rvkshn-10/Triple-Drift-Synth/BOM.csv

Item | Qty | Supplier | Cost/item | Total Cost | link
NE555P DIP-8 timer | 3 | Tayda | $0.25 | $0.75 | https://www.taydaelectronics.com/ne555-ic-555-timer-dip-8.html
LM386N-1 DIP-8 amplifier | 1 | Tayda | $0.85 | $0.85 | https://www.taydaelectronics.com/lm386-audio-amplifier-1-channel-mono-class-ab-325mwx1at8-ohm-4v-12v-pdip-8.html
1N5817 Schottky diode | 1 | Tayda | $0.06 | $0.06 | https://www.taydaelectronics.com/1n5817-diode-schottky-1a-20v.html
22 ohm 1/4W resistor | 10 | Tayda | $0.12 | $1.20 | https://www.taydaelectronics.com/save-time-easy-group-3.html
10 ohm 1/4W resistor | 1 | Tayda | $0.12 | $0.12 | https://www.taydaelectronics.com/save-time-easy-group-3.html
1k ohm 1/4W resistor | 1 | Tayda | $0.12 | $0.12 | https://www.taydaelectronics.com/save-time-easy-group-3.html
4.7k ohm 1/4W resistor | 10 | Tayda | $0.12 | $1.20 | https://www.taydaelectronics.com/save-time-easy-group-3.html
10k ohm 1/4W resistor | 1 | Tayda | $0.12 | $0.12 | https://www.taydaelectronics.com/save-time-easy-group-3.html
100k ohm 1/4W resistor | 1 | Tayda | $0.12 | $0.12 | https://www.taydaelectronics.com/save-time-easy-group-3.html
470uF 16V radial capacitor | 2 | Tayda | $0.06 | $0.12 | https://www.taydaelectronics.com/capacitors/electrolytic-capacitors/470uf-16v-105c-radial-electrolytic-capacitor-8x12mm.html
100nF 50V ceramic bypass capacitor (buy 10; use 5) | 10 | Tayda | $0.01 | $0.10 | https://www.taydaelectronics.com/capacitors/ceramic-disc-capacitors/test-group-2-caps.html
100nF 100V 5% film capacitor | 6 | Tayda | $0.10 | $0.60 | https://www.taydaelectronics.com/0-1uf-100v-5-kemet-polyester-film-box-type-capacitor.html
10nF 50V ceramic bypass capacitor (buy 10; use 3) | 10 | Tayda | $0.01 | $0.10 | https://www.taydaelectronics.com/capacitors/ceramic-disc-capacitors/test-group-2-caps.html
1uF 100V film capacitor | 1 | Tayda | $0.21 | $0.21 | https://www.taydaelectronics.com/1uf-100v-5-polyester-film-box-type-capacitor-jfj.html
10uF 50V radial capacitor | 1 | Tayda | $0.04 | $0.04 | https://www.taydaelectronics.com/capacitors/electrolytic-capacitors/10-uf-50v-85c-electrolytic-capacitor-aishi-6985.html
220uF 25V radial capacitor | 1 | Tayda | $0.25 | $0.25 | https://www.taydaelectronics.com/capacitors/electrolytic-capacitors/220uf-25v-105c-radial-electrolytic-capacitor-8x11.html
47nF 100V film capacitor | 1 | Tayda | $0.07 | $0.07 | https://www.taydaelectronics.com/47nf-0-047uf-100v-5-polyester-film-box-type-capacitor.html
B100k linear 6mm round shaft pot | 3 | Tayda | $0.39 | $1.17 | https://www.taydaelectronics.com/100k-ohm-linear-taper-potentiometer-with-solder-lug-shaft-dia-6mm.html
A100k log 6mm round shaft pot | 3 | Tayda | $0.50 | $1.50 | https://www.taydaelectronics.com/potentiometer-variable-resistors/rotary-potentiometer/logarithmic/100k-ohm-logarithmic-taper-potentiometer-round-shaft-solder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
A10k log 6mm round shaft pot | 1 | Tayda | $0.50 | $0.50 | https://www.taydaelectronics.com/10k-ohm-logarithmic-taper-potentiometer-round-shaft-solder-lugs-13579.html
Mini SPDT ON-ON toggle | 5 | Tayda | $0.47 | $2.35 | https://www.taydaelectronics.com/electromechanical/switches-key-pad/toggle-switch/mini-toggle-switch-spdt-on-on.html
12mm normally-open PLAY button | 1 | Tayda | $0.22 | $0.22 | https://www.taydaelectronics.com/electromechanical/switches-key-pad/push-button/push-button-switch-momentary-spst-3a-125vac-12mm-red.html
9V battery snap | 1 | Tayda | $0.20 | $0.20 | https://www.taydaelectronics.com/9v-9-volt-battery-clip-connector-snap-t-type.html
57mm 8 ohm 1W speaker HY57MS0810-H8.4 | 1 | Tayda | $0.95 | $0.95 | https://www.taydaelectronics.com/hardware-tools/speakers/mylar-speaker-8-ohm-1w.html
22 AWG stranded hookup wire, brown | 10 | Tayda | $0.10 | $1.00 | https://www.taydaelectronics.com/awg-22-brown-hook-up-wire-1ft-30cm-stranded-600v.html
PCB fabrication batch of 5 | 1 | JLCPCB | $2.00 | $2.00 | https://jlcpcb.com/
3D print base | 1 | JLC3DP | $10.85 | $10.85 | https://jlc3dp.com/
3D print lid | 1 | JLC3DP | $4.43 | $4.43 | https://jlc3dp.com/
3D print grip-knob | 7 | JLC3DP | $0.32 | $2.24 | https://jlc3dp.com/
3D print speaker-bridge | 1 | JLC3DP | $0.32 | $0.32 | https://jlc3dp.com/
3D print battery-pull-grip | 1 | JLC3DP | $0.32 | $0.32 | https://jlc3dp.com/
1.5mm heat-shrink tubing, red, 20cm | 5 | Tayda | $0.50 | $2.50 | https://www.taydaelectronics.com/heat-shrink-tubing-20cm-1-5mm-red.html
Estimated total shipping | 1 |  |  | $45.49
