rvkshn-10/Triple-Drift-Synth/cad/cost-revision/reused-M3-knob-detail.png

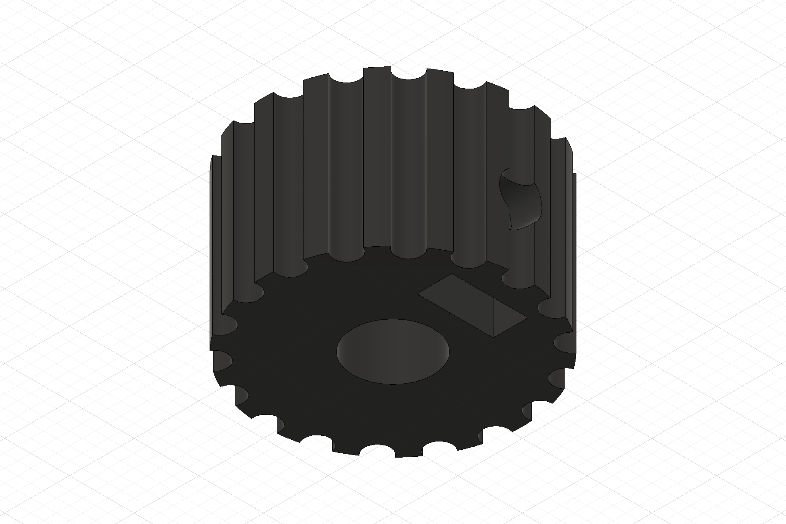
cad/cost-revision/reused-M3-knob-detail.png
