rvkshn-10/Triple-Drift-Synth/cad/cost-revision/speaker-mount.png

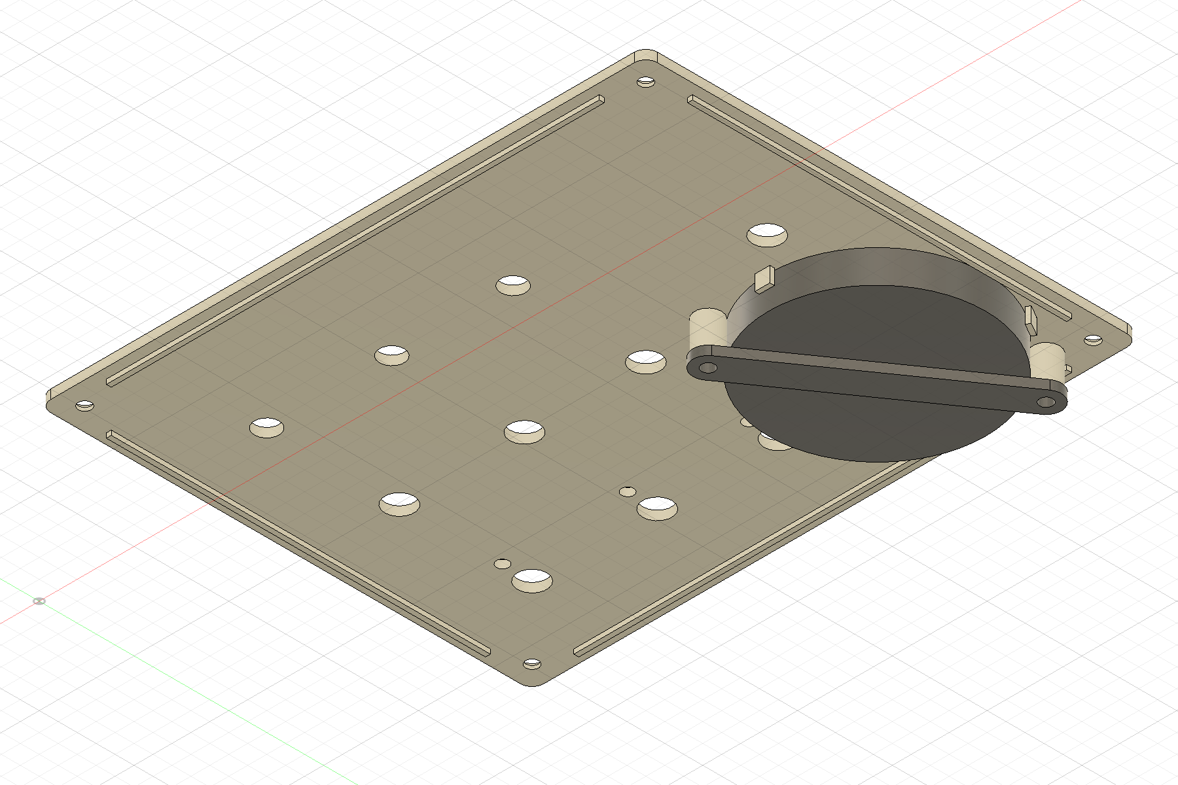
cad/cost-revision/speaker-mount.png
