rvkshn-10/Triple-Drift-Synth/cad/cost-revision/top.png

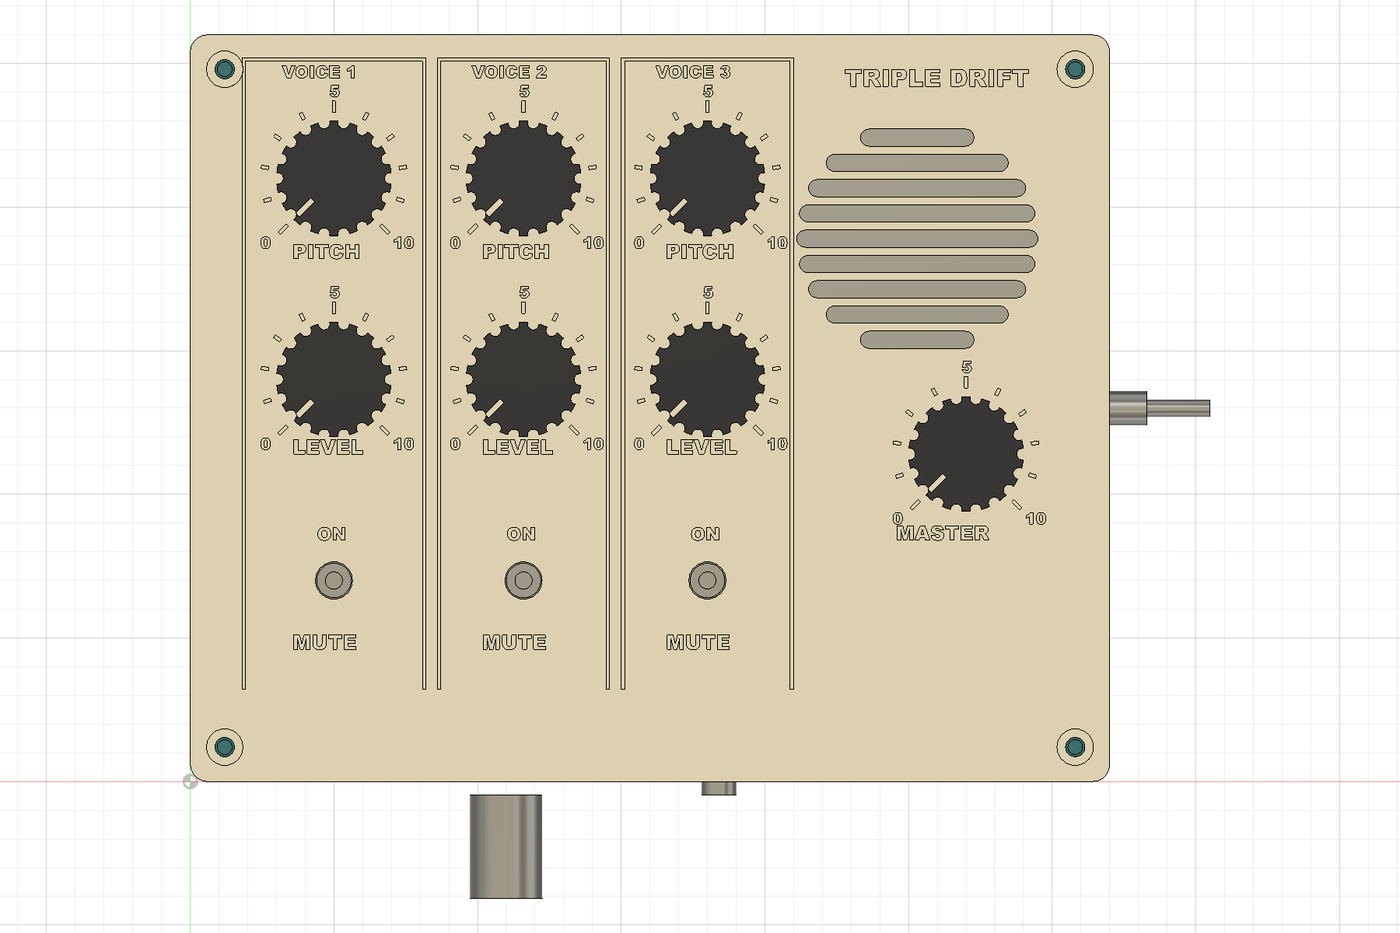
cad/cost-revision/top.png
