rvkshn-10/Triple-Drift-Synth/cad/cost-revision/print-files/TripleDrift-base.stl

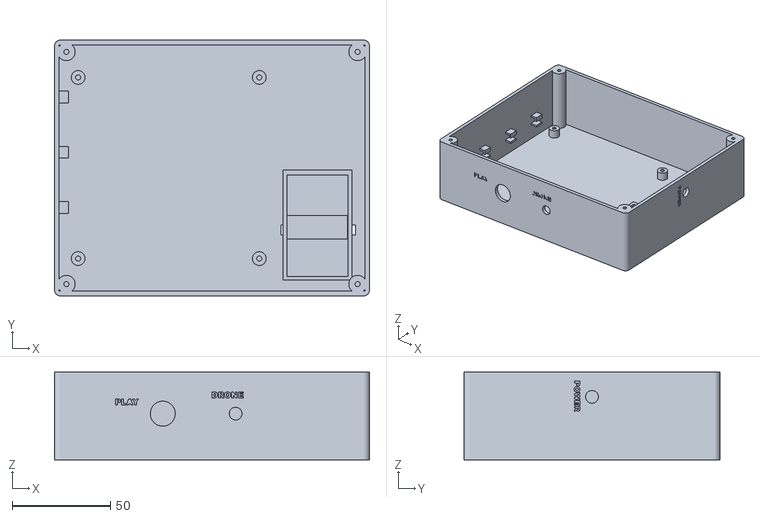
[picture p6: CAD file, 2026-10-25]
cad/cost-revision/print-files/TripleDrift-base.stl
160.0 x 130.0 x 44.6
