rvkshn-10/Triple-Drift-Synth/cad/cost-revision/TripleDrift-CostRevision.step

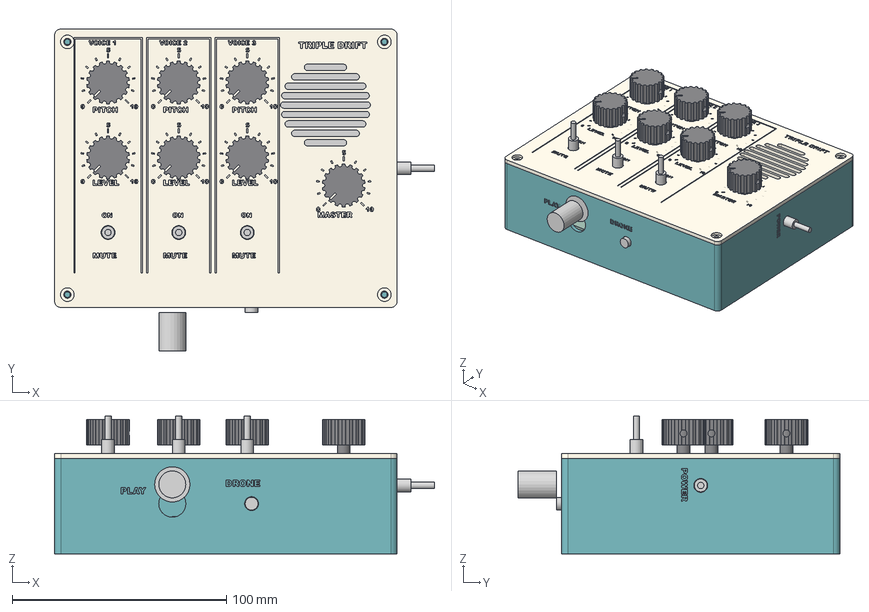
[picture p7: CAD file, 2026-10-25]
cad/cost-revision/TripleDrift-CostRevision.step
177.4 x 150.3 x 64.4 mm
DIP-8_W7.62mm_1 x 4
C_Disc_D50mm_W25mm_P500mm x 15
R_Axial_DIN0207_L63mm_D25mm_P1016mm_Horizontal x 16
PinHeader_1x02_P254mm_Vertical x 8
PinHeader_1x03_P254mm_Vertical x 7
C_Rect_L7.2mm_W2.5mm_P5.00mm_1
CP_Radial_D80mm_P350mm x 3
CP_Radial_D50mm_P200mm
D_DO-41_SOD81_P10.16mm_Horizontal_1
TripleDrift_PCB
