rvkshn-10/Triple-Drift-Synth/cad/cost-revision/print-files/TripleDrift-lid.stl

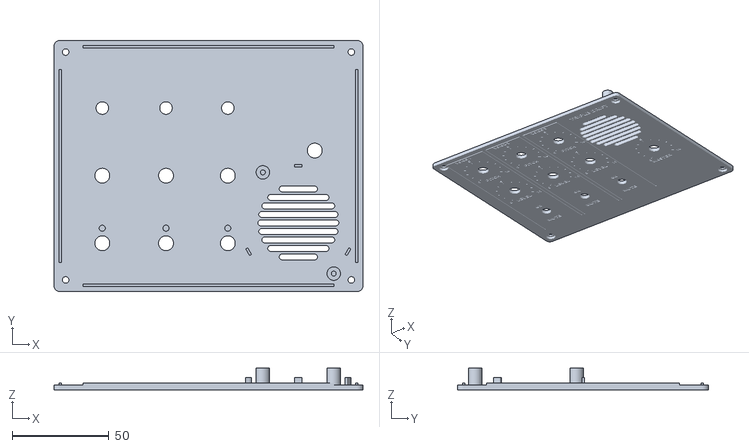
[picture p8: CAD file, 2026-10-25]
cad/cost-revision/print-files/TripleDrift-lid.stl
160.0 x 130.0 x 11.2
