rvkshn-10/Triple-Drift-Synth/cad/cost-revision/print-files/TripleDrift-battery-pull-grip.stl

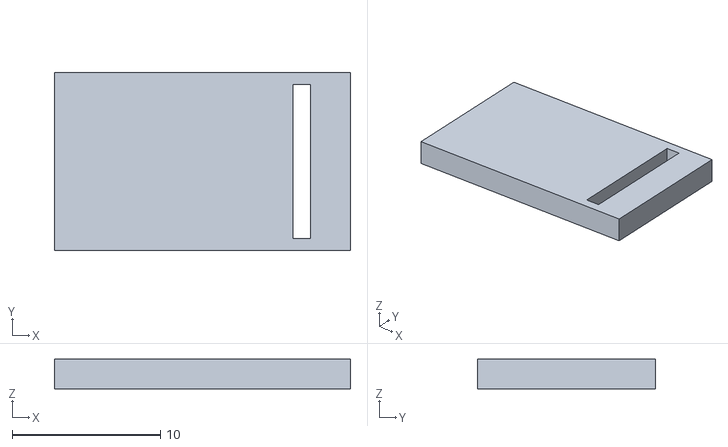
[picture p9: CAD file, 2026-10-25]
cad/cost-revision/print-files/TripleDrift-battery-pull-grip.stl
20.0 x 12.0 x 2.00
