rvkshn-10/Triple-Drift-Synth/cad/cost-revision/print-files/TripleDrift-grip-knob.stl

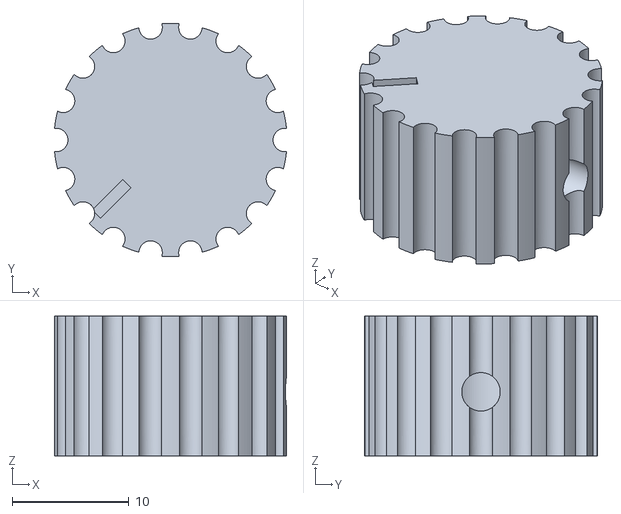
[picture p10: CAD file, 2026-10-25]
cad/cost-revision/print-files/TripleDrift-grip-knob.stl
19.9 x 20.0 x 12.0
