rvkshn-10/Triple-Drift-Synth/cad/cost-revision/print-files/TripleDrift-speaker-bridge.stl

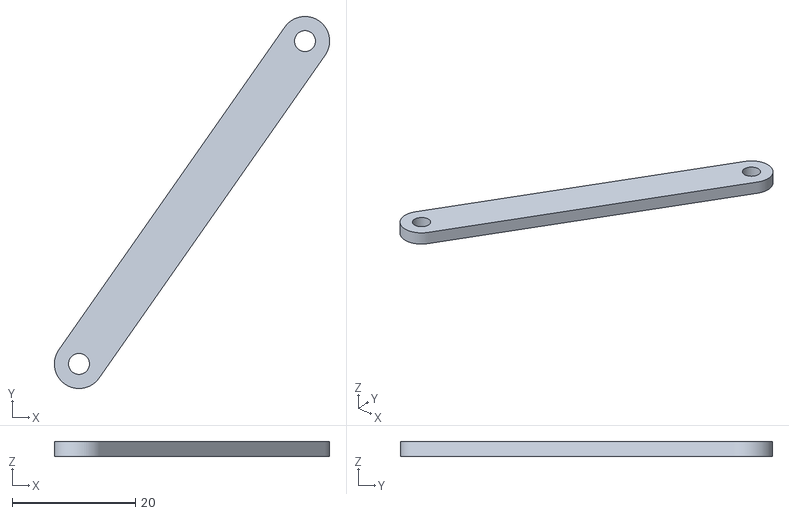
[picture p11: CAD file, 2026-10-25]
cad/cost-revision/print-files/TripleDrift-speaker-bridge.stl
44.7 x 60.4 x 2.40
