rvkshn-10/Triple-Drift-Synth/(list of files, cad)

Other CAD files:
cad/cost-revision/TripleDrift-CostRevision.f3d
