rvkshn-10/Triple-Drift-Synth/cad/cost-revision/assembled.png

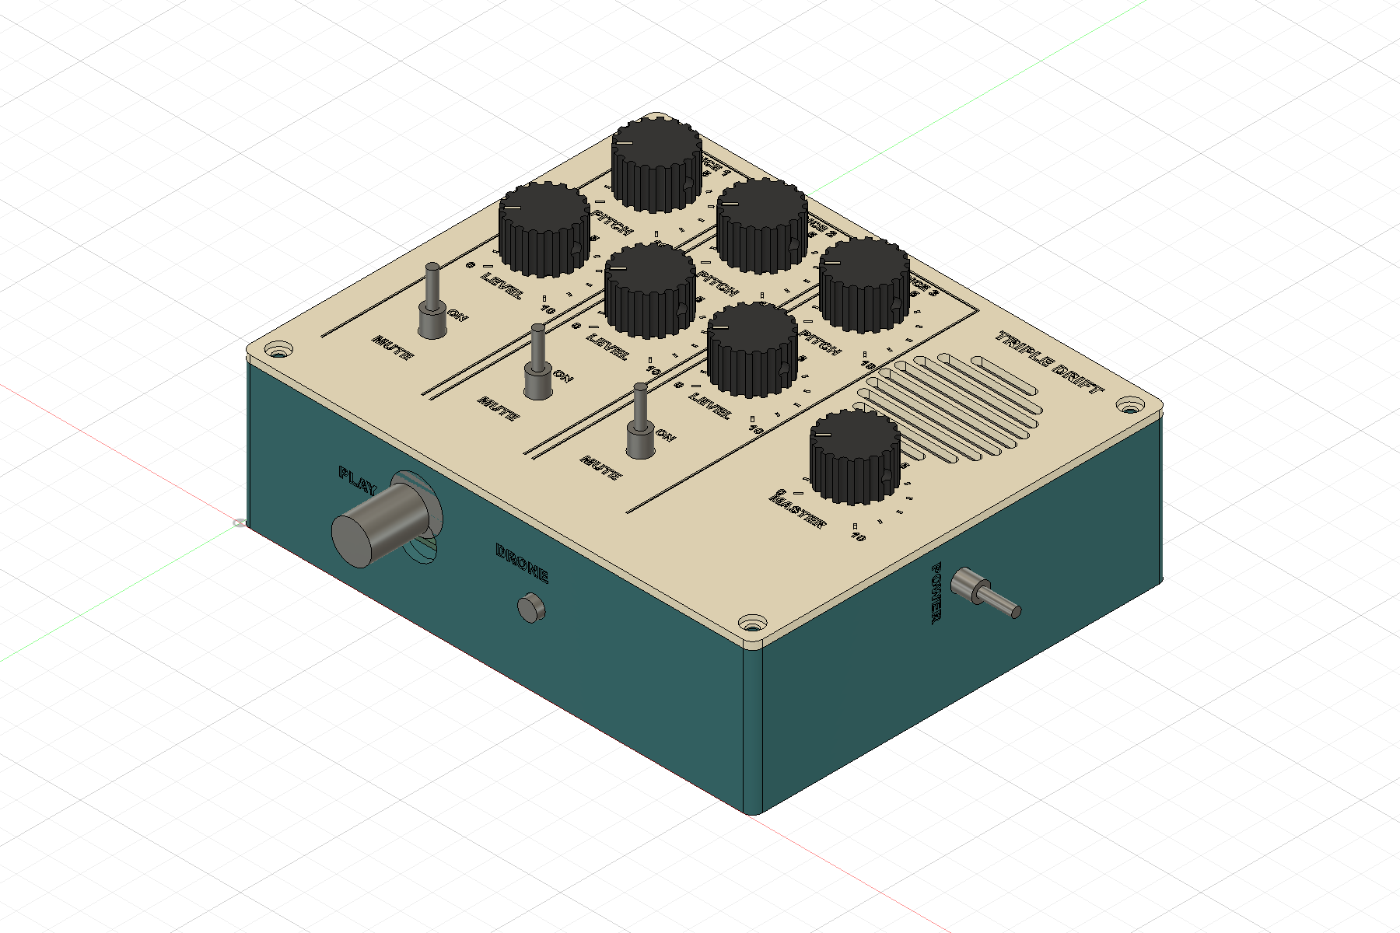
cad/cost-revision/assembled.png
