rvkshn-10/Triple-Drift-Synth/JOURNAL.md

# Triple Drift Desktop Synth – devlog

<!-- Generated by Half Life from project cmvfd73yg000001q7hnh0gmxl. Edits here are overwritten on the next sync. -->
<!-- Generated: 2026-10-24T23:02:02.855Z -->

> [!NOTE]
> This devlog is mirrored from [Half Life](https://halflife.hackclub.com) – [open the project](https://halflife.hackclub.com/projects/cmvfd73yg000001q7hnh0gmxl). Editing it here will not change the platform's copy, and the next sync overwrites this file.

> Desktop synth with three 555 oscillators, each with a pitch knob and mute switch and a mixer so we can blend the voices, a Master volume, a small amplifier and a built in speaker. A Play button along with a continuous drone mode along with a printed enclosure.  (Cover image is AI btw)

| Week | Tier | Hours logged | Entries |
| --- | --- | --- | --- |
| Week 3 | Tier 2 | 33h | 3 |

## Contents

1. [2026-10-20 – October 20th](#2026-10-20-october-20th)
2. [2026-10-21 – October 21st](#2026-10-21-october-21st)
3. [2026-10-24 – October 24th](#2026-10-24-october-24th)

## Design

### 2026-10-20 – October 20th

**11h**

October 20th

To build a desktop synth, I divided my work into 3 different phases, the first phase is the PCB phase, then it's CAD phase, and finally the Refinement phase.

First I began with planning the circuit, I established the signal flow of three 555 oscillators feed individual level controls, a mixer, and a speaker amplifier. Also planned the battery power and play/drone controls.
01-architecture

I then started designing the first voice, I created one complete 55 oscillator circuit with adjustable pitch, a mute switch, and an output-level control
02-single-voice

I later added all three voices, by repeating the oscillator circuit to create three independently adjustable voices that can be mixed together.
03-three-voice-schematic

Next I added the power and playback controls, apparently for this one I needed a battery-polarity protection, supply filtering. But I also had the PLAY and DRONE controls that enabled the oscillators.
04-power-play-drone

I continued by designing the speaker amplifier, I added the master volume control, LM386 amplifier, output capacitor, and supporting components to drive an external speaker.
05-speaker-amplifier

Then I I had to use the KiCad Rules Checker, and the Schematic passed with 0 errors and 0 warnings. At this point I was done with the schematic.
06-erc-zero-violations

I later arranged the through hole components and control headers on a 100x100mm board, with 4 mounting holes for the future enclosure when I complete phase 2.
07-pcb-placement

-Short break-

Next I routed the PCB by connecting the component pads using copper traces on both sides of the board. The completed routing had 0 unconnected pads.
08-complete-routing

Then I inspected the power, mixer, and speaker amplifier area in detail and refined the silkscreen labels to avoid overlaps.
09-amplifier-routing-detail

Then I ran the KiCad Design rules checker to check layout against manufacturing rules. The board passed with 0 errors, 0 warnings, and 0 unconnected pads.
10-drc-zero-violations

Finally I took a look at the board in 3d, to view the finished PCB with component models to review the layout and prepare a reference for Phase 2 enclosure design.
11-pcb-3d-view

P.S. This entry doesn't include information of me researching how to do this project and best things to use because I forgot to take screenshots.

### 2026-10-21 – October 21st

**10h**

October 21st

I started with the enclosure footprint and reserved space for the 100mmx100mm PCB, controls, speaker and battery. This helped me decide a layout before adding the case features.
01-footprint-layout

I next created the base by building the hollow enclosure with 2.4mm walls and floor, then rounded the outside corners. The open top gives access for installing and wiring the electronics
02-hollow-base

I then needed to add supports so I created 4 mounting posts aligned to the board's 92 mm hole spacing. And then blind screw pilot holes keep the screw paths above the bottom surface.
03-pcb-standoffs

I then created internal mounting features. I added the battery rails and stops, cable tie slots, and 4 corner pillars for securing the lid. The top view shows the placement around the PCB space. The rear cradle corners received a small joining repair during final mesh validation.
04-battery-cradle-lid-pillars

I next had to open the case for controls, so I cut the front Play Button and Drone switch holes, and the right side power switch hole. The sizes are provisional until the exact controls were selected.
05-front-side-control-holes

Then I had to lay out the panel, so I created the lid and placed openings for 3 pitch pots, 3 level pots, and 2 mute switches, master volume, and the 4 lid screws.
06-lid-control-layout

I later got inspirations for this next idea from my PC, where it had speaker grills, and I decided to incorporate that into the lid. I also modeled the underside speaker guides, so measurement was key here, screw bosses, and a separate retaining bridge, those underside features aren't visible, but I will show them in the Reel.
07-speaker-grille

Next I planned to label stuff, so I recessed the project name, and control labels into the lid. During the final refinement I made the lettering bolder to improve its chances of printing clearly.
08-engraved-control-panel

I then checked the internal layout, so I imported the actual Phase 1 PCB STEP model, corrected its position, and checked its placement inside the base. Simplified controls, speaker, and battery show the intended packaging. Those purchased part models still need confirmation against real supplier dimensions.
09-internal-pcb-fit

Finally I assembled the teal base with he cream panel with provisional black controls and an orange PLAY button. I then checked feature health, checked printed part intersections against the available models, and exported the native Fusion design, STEP assembly, and 3 STL parts.
10-complete-enclosure

### 2026-10-24 – October 24th

**12h**

October 24th

This is  now Phase 3, where I add new features and enhance my overall workflow, so my first change was finger grip knobs, so I replaced the 7 smooth placeholder knobs with editable printable knob design having 18 finger scallops, a provisional 6.2mm shaft bore, and a M3 set screw pilot. I had to make sure base geometry was unchanged.
01-finger-grip-knobs

Next plan was to work on Knob Pointers, I id it on one knob which was reused a lot, so it updated all 7 instances together. The point was so that the setting can be read against the panel scales.
02-knob-position-pointers

Next plan was to add Pitch scales, by adding 11 engraved tick marks, 0, 5, 10 labels around each pitch knob. I had to move the title and voices headings to visibly view the scales though.
03-numbered-pitch-scales

Next was to add volume scales, I added matching scales around the 3 voice level knobs and master volume. These are relative settings, not calibrated frequencies or decibels (because it really doesn't matter).
04-volume-scales

Next I added voice groups, so I engraved 3 open bottom borders to group each voice's pitch, level, and mute controls.
05-voice-grouping-borders

I next created mute positions, by adding an ON above each mute toggle, opposite the existing MUTE labels. Final switch orientation and wiring must match the labels during assembly. ( a note to be added to the GitHub)
06-on-and-mute-labels

Next was to create external labels, I engraved the PLAY and DRONE on the front wall, and POWER on the right wall beside their existing mounting holes.
07-play-drone-power-labels

Next I added recessed lid screws, by adding four 6.4mm diameter, and 1.5mm deep screw head pockets. Flush mounting requires suitably low profile screwheads, the ordinary pan heads may protrude.
08-recessed-lid-screw-heads

Next I wanted to work on wiring, so I added wire routing clips, by adding three C-shaped retaining clips along the left interior wall. This view hides the electronics so the clips are visible. They keep the intended wire path beside the PCB.
09-internal-wire-routing-clips

The next step was the Battery pull tab, so I added a shallow ribbon channel beneath the battery and a separate printed grip with a matching ribbon slot, the orange grip and cream ribbon ref are shown about the battery. Ribbon material might have to be bought.
10-battery-pull-tab

Next I made rubber foot pockets, by recessing four 12.4 mm diameter seats into the underside for nominal 12mm adhesive feet. Pocket depth is 0.6mm.
11-rubber-foot-pockets

Next I made a speaker grill, I replaced the circular perforations with 7 rounded slots within the same speaker area. The nominal webs are 1.4mm wide. I did this for a better design
12-improved-speaker-grille
