rvkshn-10/Triple-Drift-Synth/TripleDrift.kicad_pcb

## KiCad design TripleDrift.kicad_pcb (2026-10-25)

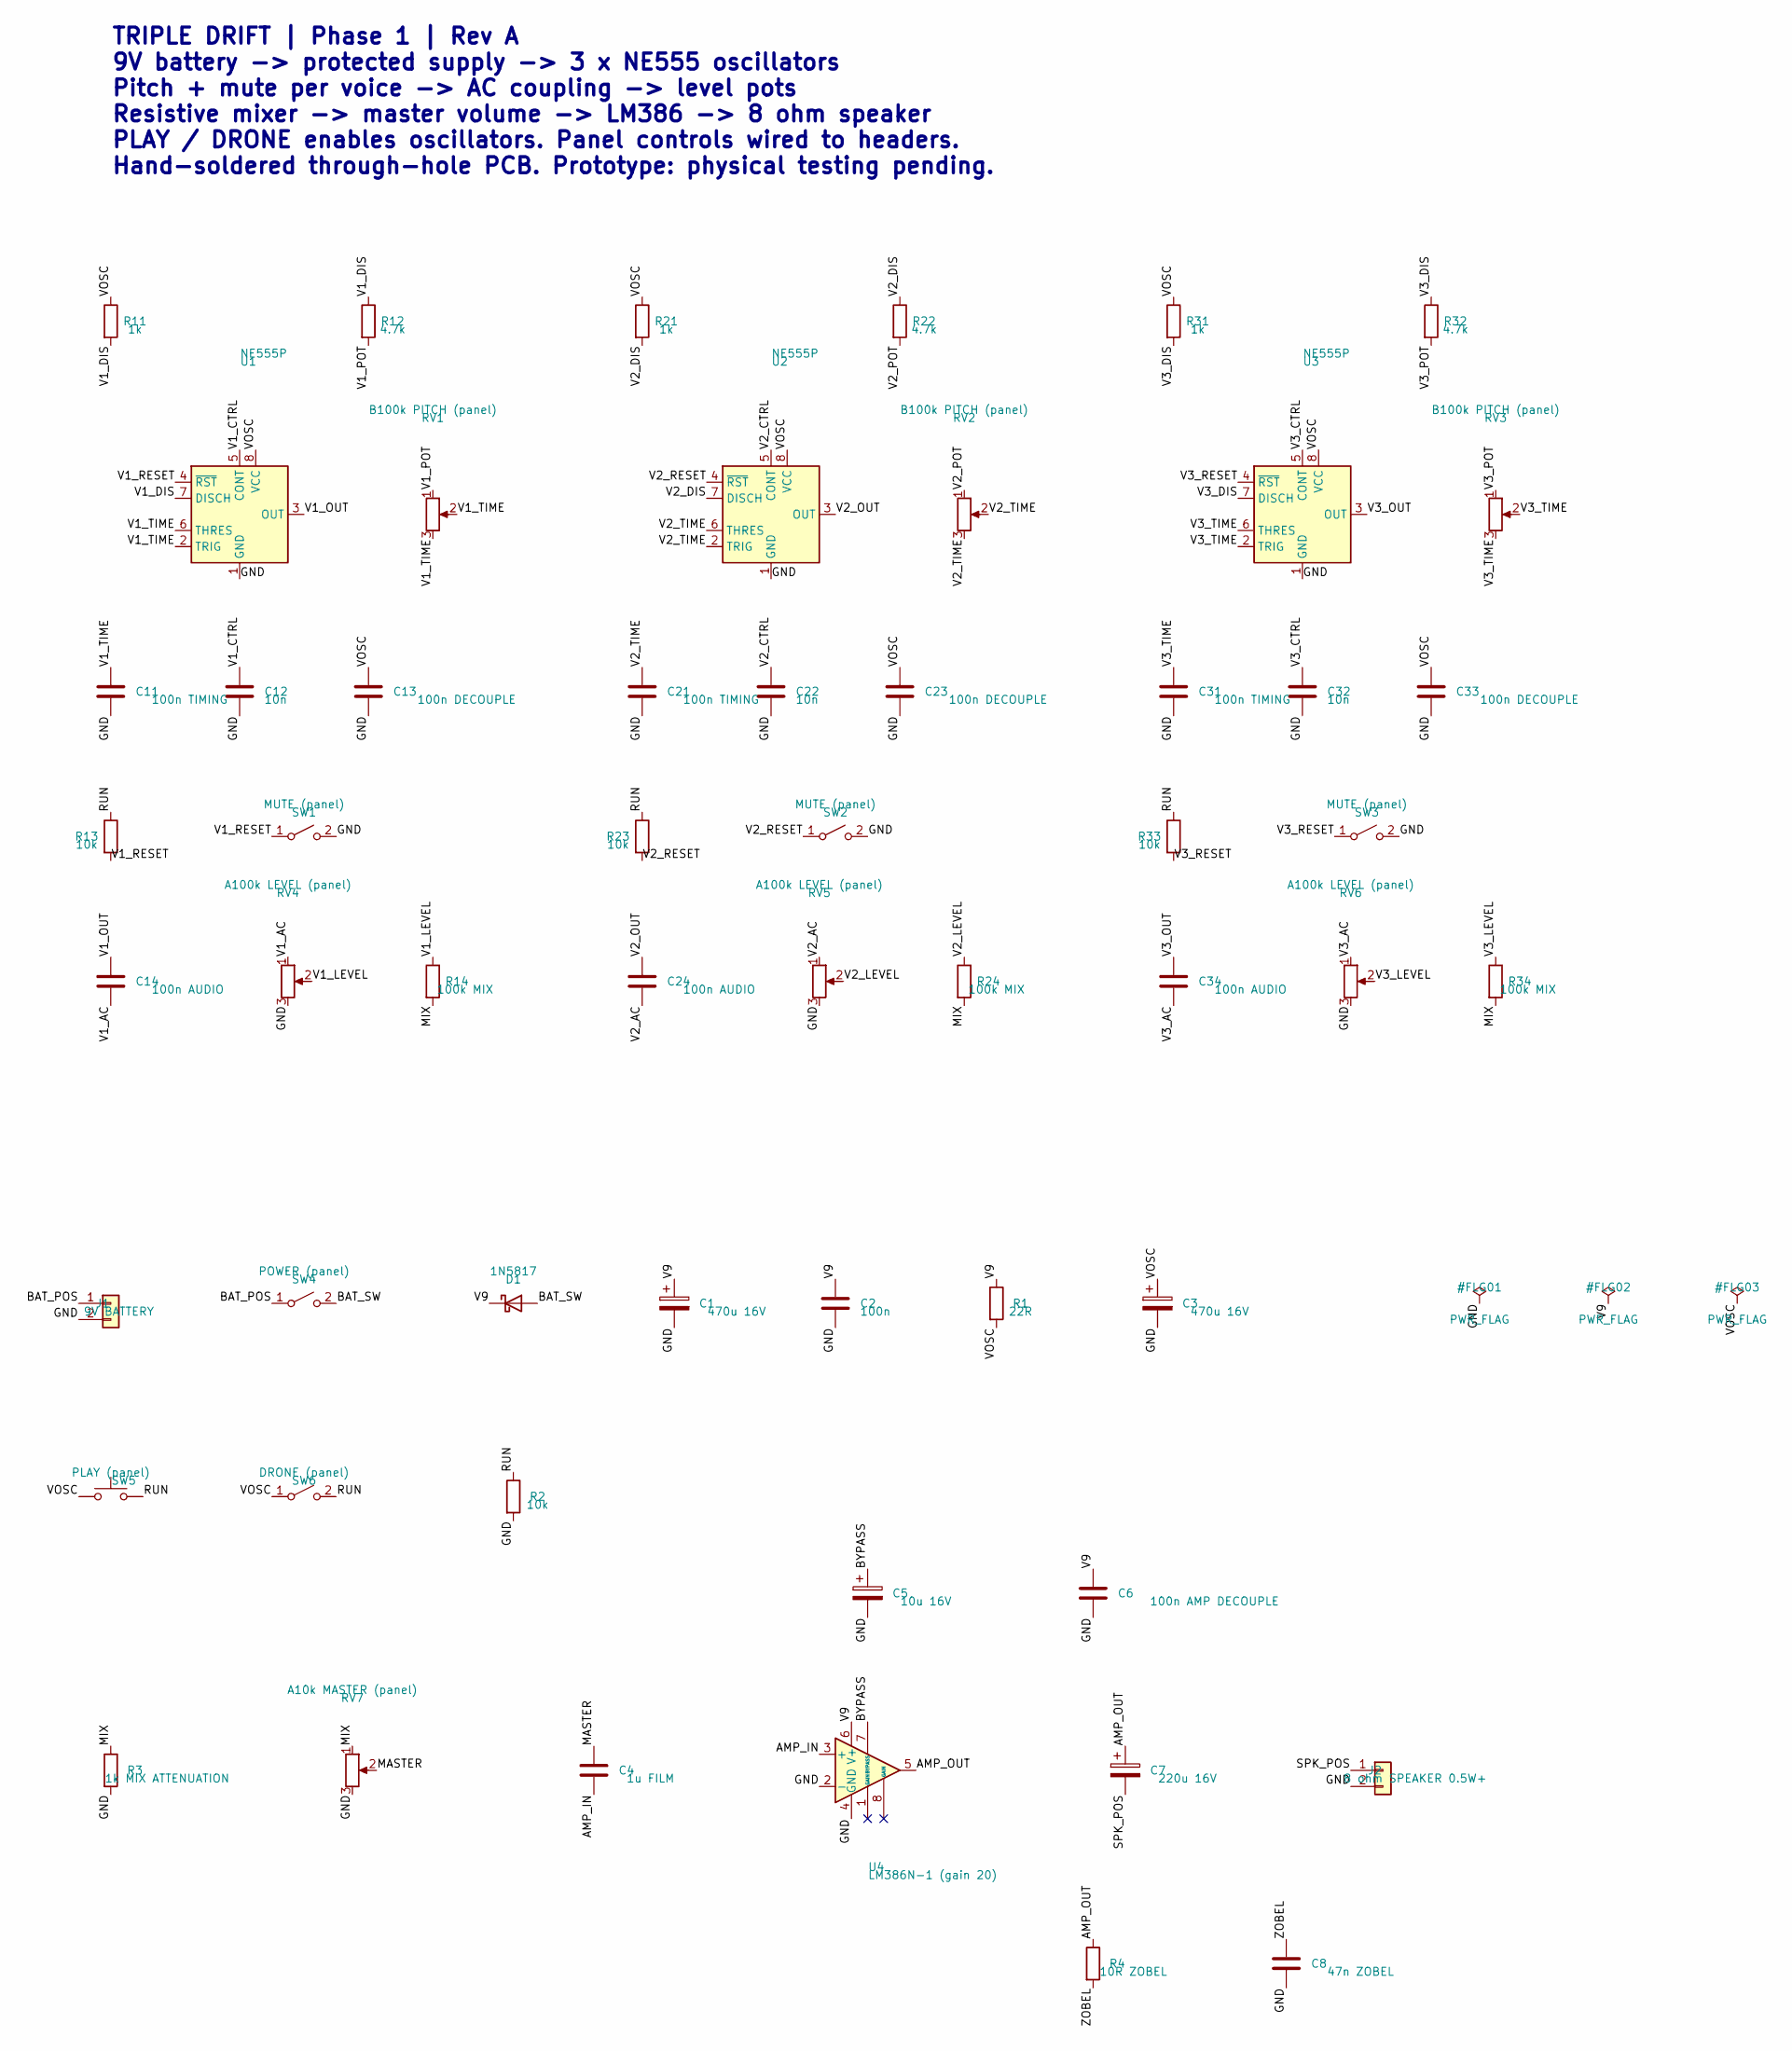
[picture p13: schematic TripleDrift.kicad_sch]

Parts:
C1, C3: 470u 16V; CP_Radial_D8.0mm_P3.50mm
C2: 100n; C_Disc_D5.0mm_W2.5mm_P5.00mm
C4: 1u FILM; C_Rect_L7.2mm_W2.5mm_P5.00mm
C5: 10u 16V; CP_Radial_D5.0mm_P2.00mm
C6: 100n AMP DECOUPLE; C_Disc_D5.0mm_W2.5mm_P5.00mm
C7: 220u 16V; CP_Radial_D8.0mm_P3.50mm
C8: 47n ZOBEL; C_Disc_D5.0mm_W2.5mm_P5.00mm
C11, C21, C31: 100n TIMING; C_Disc_D5.0mm_W2.5mm_P5.00mm
C12, C22, C32: 10n; C_Disc_D5.0mm_W2.5mm_P5.00mm
C13, C23, C33: 100n DECOUPLE; C_Disc_D5.0mm_W2.5mm_P5.00mm
C14, C24, C34: 100n AUDIO; C_Disc_D5.0mm_W2.5mm_P5.00mm
D1: 1N5817; D_DO-41_SOD81_P10.16mm_Horizontal
J1: 9V BATTERY; PinHeader_1x02_P2.54mm_Vertical
J2: 8 ohm SPEAKER 0.5W+; PinHeader_1x02_P2.54mm_Vertical
R1: 22R; R_Axial_DIN0207_L6.3mm_D2.5mm_P10.16mm_Horizontal
R2, R13, R23, R33: 10k; R_Axial_DIN0207_L6.3mm_D2.5mm_P10.16mm_Horizontal
R3: 1k MIX ATTENUATION; R_Axial_DIN0207_L6.3mm_D2.5mm_P10.16mm_Horizontal
R4: 10R ZOBEL; R_Axial_DIN0207_L6.3mm_D2.5mm_P10.16mm_Horizontal
R11, R21, R31: 1k; R_Axial_DIN0207_L6.3mm_D2.5mm_P10.16mm_Horizontal
R12, R22, R32: 4.7k; R_Axial_DIN0207_L6.3mm_D2.5mm_P10.16mm_Horizontal
R14, R24, R34: 100k MIX; R_Axial_DIN0207_L6.3mm_D2.5mm_P10.16mm_Horizontal
RV1, RV2, RV3: B100k PITCH (panel); PinHeader_1x03_P2.54mm_Vertical
RV4, RV5, RV6: A100k LEVEL (panel); PinHeader_1x03_P2.54mm_Vertical
RV7: A10k MASTER (panel); PinHeader_1x03_P2.54mm_Vertical
SW1, SW2, SW3: MUTE (panel); PinHeader_1x02_P2.54mm_Vertical
SW4: POWER (panel); PinHeader_1x02_P2.54mm_Vertical
SW5: PLAY (panel); PinHeader_1x02_P2.54mm_Vertical
SW6: DRONE (panel); PinHeader_1x02_P2.54mm_Vertical
U1, U2, U3: NE555P; DIP-8_W7.62mm
U4: LM386N-1 (gain 20); DIP-8_W7.62mm

Connections:
/AMP_IN: C4.2, U4.3 (+)
/AMP_OUT: C7.1, R4.1, U4.5
/BAT_POS: J1.1, SW4.1 (A)
/BAT_SW: D1.2 (A), SW4.2 (B)
/BYPASS: C5.1, U4.7 (BYPASS)
/GND: C1.2, C2.2, C3.2, C5.2, C6.2, C8.2, C11.2, C12.2, C13.2, C21.2, C22.2, C23.2, C31.2, C32.2, C33.2, J1.2, J2.2, R2.2, R3.2, RV4.3, RV5.3, RV6.3, RV7.3, SW1.2 (B), SW2.2 (B), SW3.2 (B), U1.1 (GND), U2.1 (GND), U3.1 (GND), U4.2 (-), U4.4 (GND)
/MASTER: C4.1, RV7.2
/MIX: R3.1, R14.2, R24.2, R34.2, RV7.1
/RUN: R2.1, R13.1, R23.1, R33.1, SW5.2, SW6.2 (B)
/SPK_POS: C7.2, J2.1
/V1_AC: C14.2, RV4.1
/V1_CTRL: C12.1, U1.5 (CONT)
/V1_DIS: R11.2, R12.1, U1.7 (DISCH)
/V1_LEVEL: R14.1, RV4.2
/V1_OUT: C14.1, U1.3 (OUT)
/V1_POT: R12.2, RV1.1
/V1_RESET: R13.2, SW1.1 (A), U1.4 (~RST)
/V1_TIME: C11.1, RV1.2, RV1.3, U1.2 (TRIG), U1.6 (THRES)
/V2_AC: C24.2, RV5.1
/V2_CTRL: C22.1, U2.5 (CONT)
/V2_DIS: R21.2, R22.1, U2.7 (DISCH)
/V2_LEVEL: R24.1, RV5.2
/V2_OUT: C24.1, U2.3 (OUT)
/V2_POT: R22.2, RV2.1
/V2_RESET: R23.2, SW2.1 (A), U2.4 (~RST)
/V2_TIME: C21.1, RV2.2, RV2.3, U2.2 (TRIG), U2.6 (THRES)
/V3_AC: C34.2, RV6.1
/V3_CTRL: C32.1, U3.5 (CONT)
/V3_DIS: R31.2, R32.1, U3.7 (DISCH)
/V3_LEVEL: R34.1, RV6.2
/V3_OUT: C34.1, U3.3 (OUT)
/V3_POT: R32.2, RV3.1
/V3_RESET: R33.2, SW3.1 (A), U3.4 (~RST)
/V3_TIME: C31.1, RV3.2, RV3.3, U3.2 (TRIG), U3.6 (THRES)
/V9: C1.1, C2.1, C6.1, D1.1 (K), R1.1, U4.6 (V+)
/VOSC: C3.1, C13.1, C23.1, C33.1, R1.2, R11.1, R21.1, R31.1, SW5.1, SW6.1 (A), U1.8 (VCC), U2.8 (VCC), U3.8 (VCC)
/ZOBEL: C8.1, R4.2

Notes on the sheet:
TRIPLE DRIFT | Phase 1 | Rev A 9V battery -> protected supply -> 3 x NE555 oscillators Pitch + mute per voice -> AC coupling -> level pots Resistive mixer -> master volume -> LM386 -> 8 ohm speaker PLAY / DRONE enables oscillators. Panel controls wired to headers. Hand-soldered through-hole PCB. Pr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

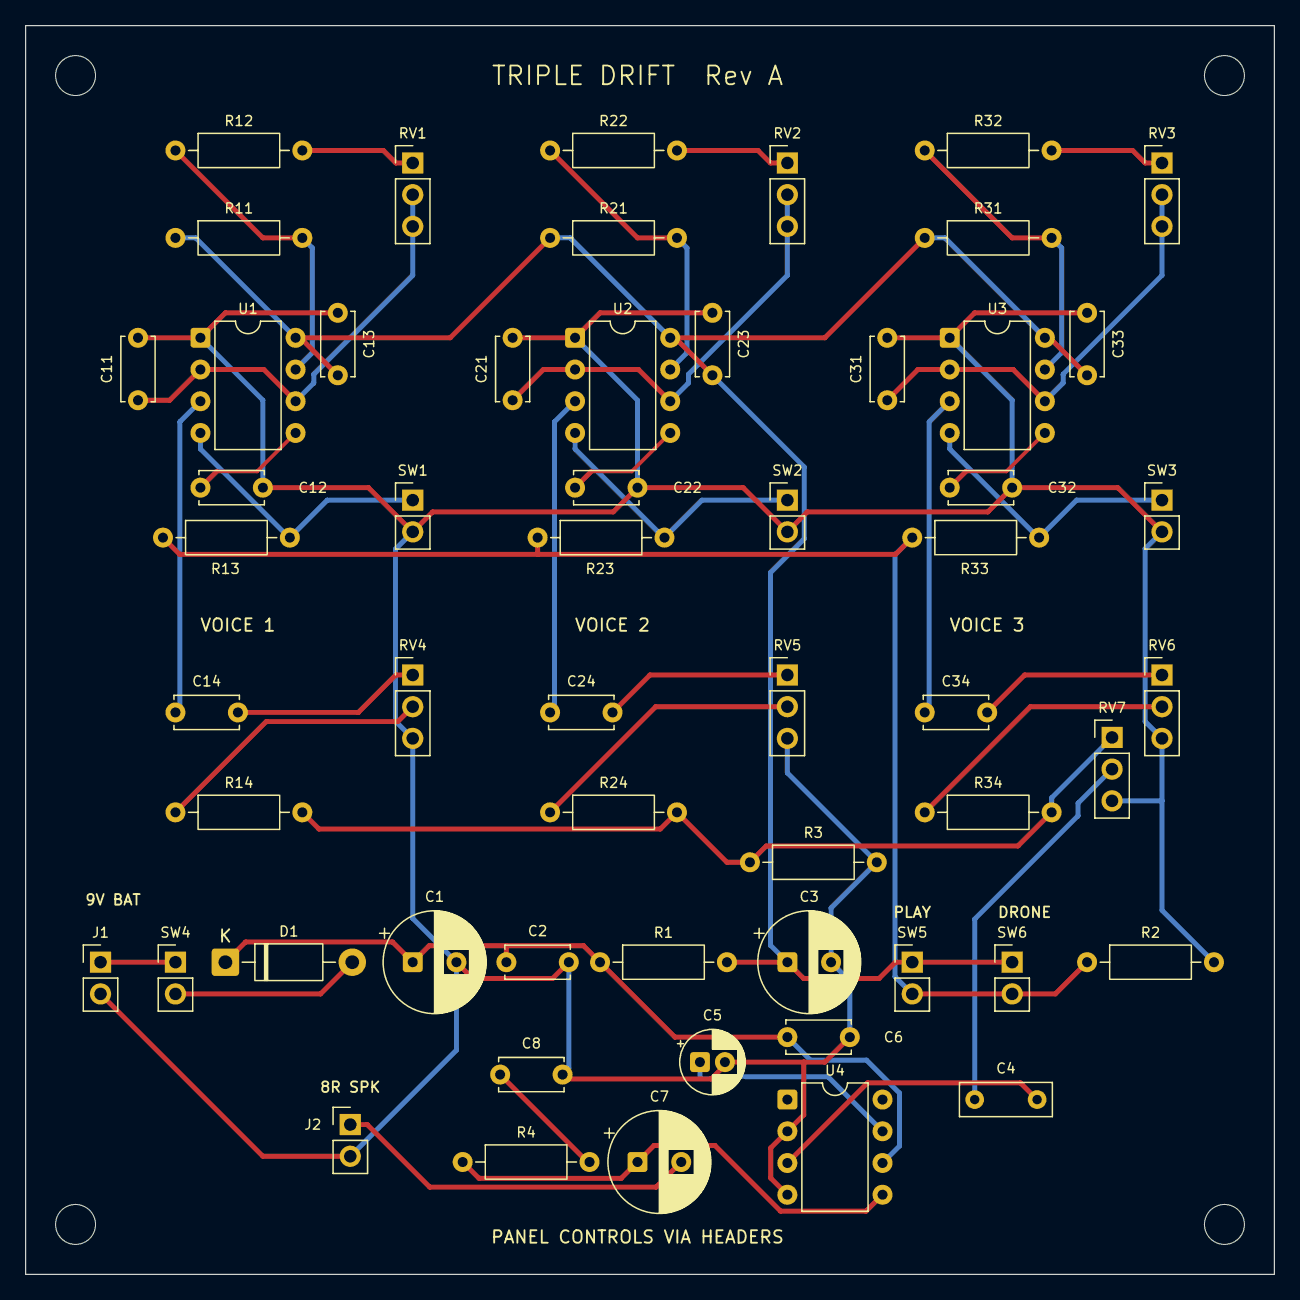
[picture p14: board TripleDrift.kicad_pcb from above]

Board: 2 copper layers, 100.0 x 100.0 mm, 60 parts (0 on the bottom side), 37 nets.

Other parts of the board:
MH1, MH2, MH3, MH4: MountingHole_3.2mm_M3
