rvkshn-10/Triple-Drift-Synth/(commit log)

2026-10-25 Add project README, images, and KiCad schematic
    [TripleDrift.kicad_sch]
2026-10-25 Sync Triple Drift Desktop Synth from Half Life
    [BOM.csv]
2026-10-25 Populate purchasing BOM with supplier prices and budget limitations
    [BOM.csv]
2026-10-25 Organize BOM columns and preserve detailed purchasing notes
    [BOM.csv]
2026-10-25 Select lower-cost parts and document matching enclosure revision
    [BOM.csv]
2026-10-25 Publish verified native CAD and print exports for cost revision
    [TripleDrift-CostRevision.f3d, TripleDrift-CostRevision.step, TripleDrift-base.stl, TripleDrift-battery-pull-grip.stl, TripleDrift-grip-knob.stl, TripleDrift-lid.stl, TripleDrift-speaker-bridge.stl]
2026-10-25 Add checked KiCad project and PCB fabrication package
    [TripleDrift-B_Cu.gbl, TripleDrift-B_Mask.gbs, TripleDrift-B_Silkscreen.gbo, TripleDrift-Edge_Cuts.gm1, TripleDrift-F_Cu.gtl, TripleDrift-F_Mask.gts, TripleDrift-F_Silkscreen.gto, TripleDrift-NPTH.drl]
2026-10-25 Restore BOM prices and match Half Life price headers
    [BOM.csv]
